PZero/YouTubeController/docs/REQUISITI.md

# Requisiti

## Controller
- Una manopola (encoder rotativo) e un pulsante.
- Collegamento Bluetooth all'iPad.
- Manopola: avanti / indietro nel video, con passo che dipende dalla velocità di rotazione (3 livelli: fine / medio / veloce, secondi regolabili nella PWA; valori iniziali 1 / 5 / 30 s da tarare).
- Pulsante: play / stop.
- Alimentazione: da definire.

## App (PWA su iPad)
- Ricerca di video YouTube.
- Riproduzione del video scelto.
- Interpreta i comandi del controller per avanti/indietro e play/stop.
- Installabile nella schermata Home.

## Scatola
- Stampabile in 3D, contiene tutta l'elettronica.
- Dimensioni, forma e finitura: da definire.

## Da chiarire
- Uso previsto (chi lo usa, in che contesto): influenza ergonomia e interfaccia.
- Autonomia desiderata, se a batteria.
- Funzioni extra (volume, video successivo, pressione lunga): fuori ambito finché non richieste.
