PZero/YouTubeController/docs/foto/anello_led_piazzole.jpg

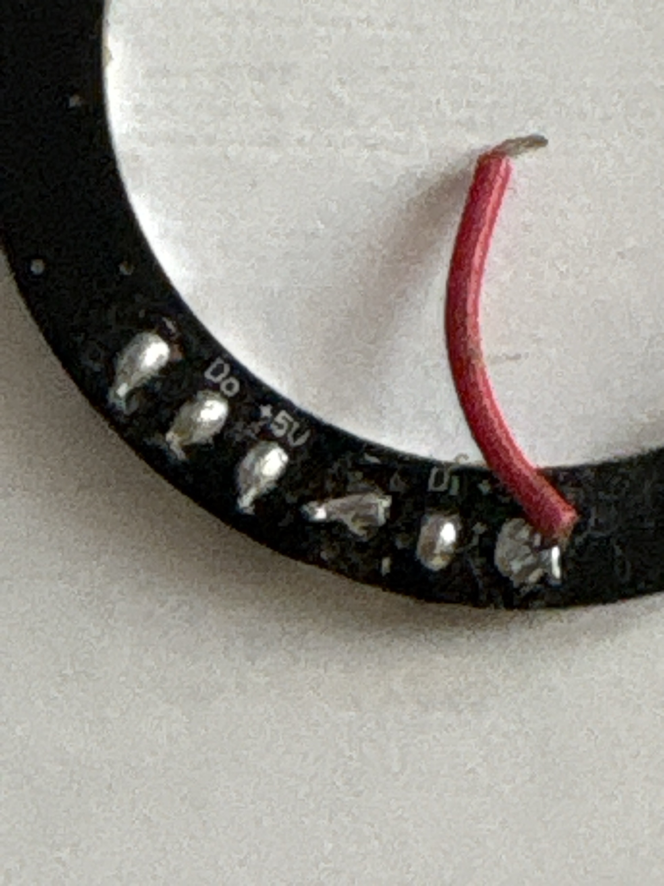
docs/foto/anello_led_piazzole.jpg
