PZero/YouTubeController/docs/foto/led_ws2812_fronte.jpg

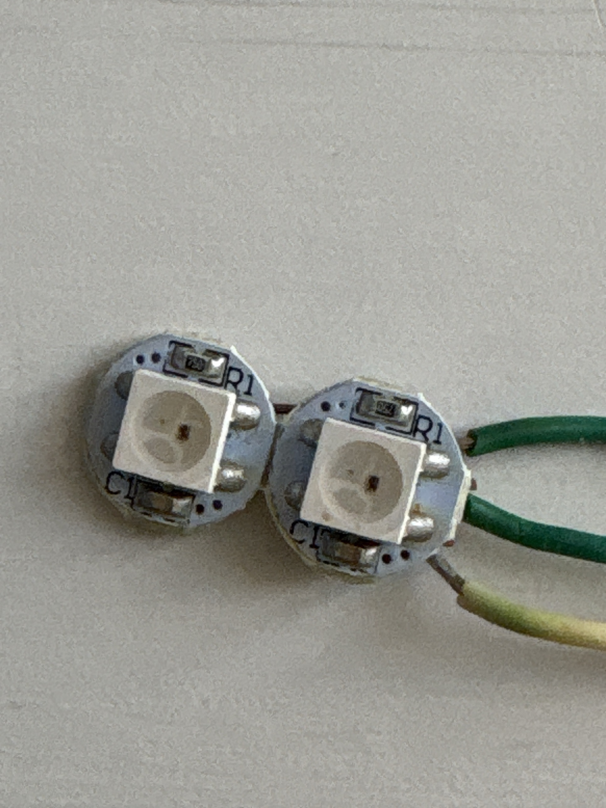
docs/foto/led_ws2812_fronte.jpg
