PZero/YouTubeController/docs/foto/led_ws2812_retro.jpg

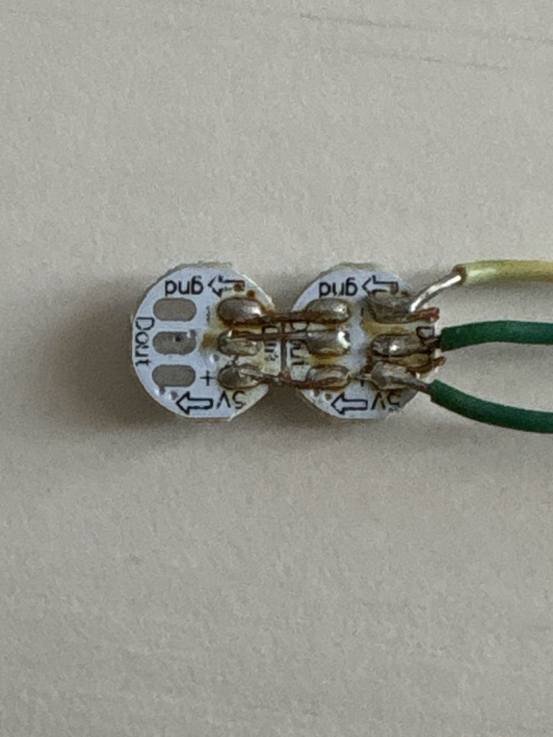
docs/foto/led_ws2812_retro.jpg
