PZero/YouTubeController/pcb/jlcpcb/render/fronte.png

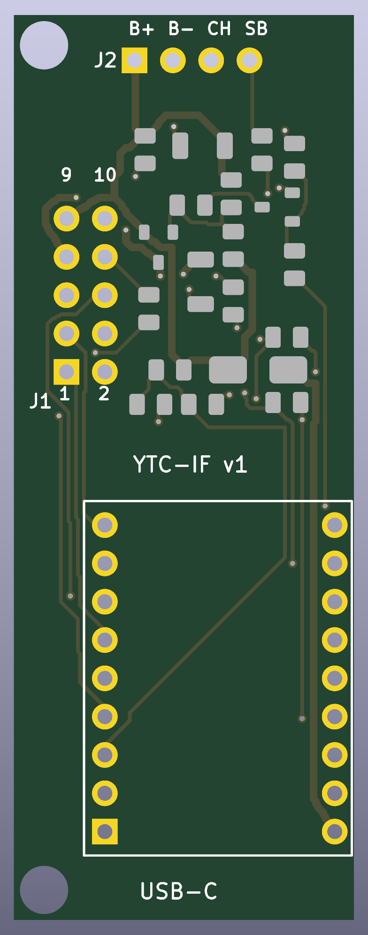
pcb/jlcpcb/render/fronte.png
