PZero/YouTubeController/pcb/jlcpcb/render/retro.png

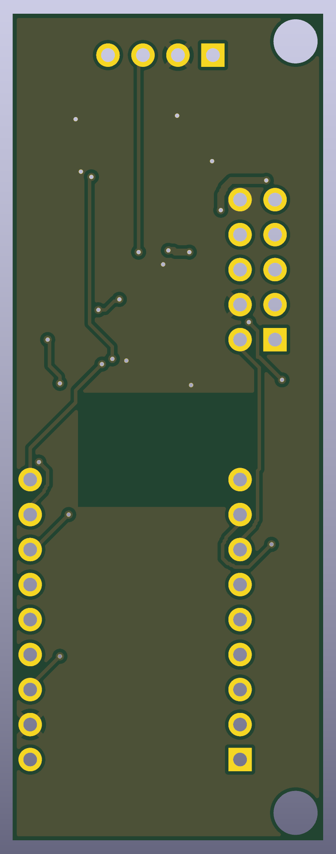
pcb/jlcpcb/render/retro.png
