PZero/YouTubeController/pcb/jlcpcb/BOM.csv

Comment | Designator | Footprint | LCSC Part #
100uF | C1 | C_1206 | C15008
100nF | C2 | C_0805 | C49678
100uF | C3 | C_1206 | C15008
100nF | C4 | C_0805 | C49678
100nF | C5 | C_0805 | C49678
SS14 | D1 | D_SMA | C2480
AO3401A | Q1 | SOT-23 | C15127
MMBT3904 | Q2 | SOT-23 | C20526
4.7k | R1 | R_0805 | C17673
10k | R2,R4,R6,R8 | R_0805 | C17414
2.2k | R3 | R_0805 | C17520
330 | R5 | R_0805 | C17630
100k | R7,R9 | R_0805 | C149504
220k | R10,R11 | R_0805 | C17556
