PZero/YouTubeController/enclosure/verifica_interferenze.scad

// ======================================================================
//  VERIFICA INTERFERENZE (non e' un pezzo da stampare)
//  Per ogni chk = 1..24 esporta l'intersezione tra gruppi di pezzi/componenti:
//    openscad -o chkN.stl -D chk=N verifica_interferenze.scad
//  Esito atteso: "Current top level object is empty" oppure volume 0 (solo facce a contatto:
//  chk 4, 7, 8, 14). Eccezione voluta: chk 11 = piccole nervature di pinzatura del modulo vibrazione
//  (pinch 0,15 mm sui labbri). chk 19 (radici dei ganci nella parete) = solo contatto.
//  Gli inviluppi (encoder_env, led_ring_env, vib_top_env, mf_env, mf_sm_env, cn_env, plug_env) stanno in componenti.scad.
//  2026-10-15 (V1): pacco elettronico LIBERO nella corsia sinistra (pk_env, chk 13 e 24 agli estremi della corsia),
//  connettore volante in tasca (cn_env, chk 21), spina USB-C nella presa del TP4056 dal retro (plug_env, chk 22).
//  Pulsante PBS-110 eliminato il 2026-10-14: chk 2 e 5 (pulsante e cappuccio) ora sono il modulo vibrazione.
// ======================================================================
include <youtube_control.scad>
mode = "none";
chk = 1;
module enc() top_frame() translate([K.x,K.y,0]) encoder_env();
module cell() battery_model();
module elec() { tp4056_model(); }          // TP4056 (il pacco SuperMini + millefori e' mf() = pk_env)
module cn()   cn_env();
module knobw() top_frame() translate([K.x,K.y,knob_gap]) knob();
module knobp() top_frame() translate([K.x,K.y,knob_gap - enc_travel]) knob();   // manopola a fine corsa del pulsante
module collw() if (!led_ring) top_frame() translate([K.x,K.y,0]) collar();
module ring()  top_frame() translate([K.x,K.y,0]) led_ring_env();
module diffw() top_frame() translate([K.x,K.y,0]) diffuser();
module vt()    top_frame() vib_top_env();
module vtp()   top_frame() vib_top_pcb();
module mf()    pk_env();
module newp()  { ring(); vt(); mf(); }
module ringx() top_frame() translate([K.x,K.y,0]) led_ring_model();   // modello (LED reali, non inviluppo)
module ring_feat() top_frame() translate([K.x,K.y,0]) { lr_arms(); lr_stops(); lr_pockets(); }
module encm()  top_frame() translate([K.x,K.y,0]) encoder_model();      // modello (dado, bussola, albero)
if (chk==1)  intersection() { body(); union() { sled(); cell(); elec(); mf(); cn(); } }
if (chk==2)  intersection() { vt();  union() { sled(); cell(); elec(); mf(); cn(); ring(); enc(); } }   // modulo vibrazione vs resto
if (chk==3)  intersection() { enc();  union() { sled(); cell(); elec(); body(); knobw(); collw(); newp(); } }
if (chk==4)  intersection() { union() { cell(); elec(); } sled(); }
if (chk==5)  intersection() { vt(); knobw(); }
if (chk==6)  intersection() { body(); on_walls() panel_local(); }
if (chk==7)  intersection() { sled(); lid(); }
if (chk==8)  intersection() { body(); lid(); }
if (chk==9)  intersection() { union() {knobw(); collw();} body(); }
// nuovi
if (chk==10) intersection() { ringx(); union() { body(); sled(); cell(); elec(); vt(); mf(); knobw(); diffw(); } }
if (chk==11) intersection() { vtp(); body(); }                         // solo PCB vs scocca: nervature di pinzatura (voluto, ~3 mm3)
if (chk==20) intersection() { vt(); body(); }                          // PCB + motore vs scocca: i labbri coprono 1,0 del bordo: nessun componente entro 1,0 dal bordo (~24 mm3 = solo labbri)
if (chk==12) intersection() { vt(); union() { sled(); cell(); elec(); mf(); cn(); lid(); } }
if (chk==13) intersection() { mf(); union() { sled(); cell(); elec(); } }          // millefori (PCB, saldature, componenti) vs portaschede/cella/TP4056/SuperMini: contatto sui sostegni
if (chk==14) intersection() { diffw(); union() { body(); knobw(); } }
if (chk==15) intersection() { on_walls() panel_local(); union() { sled(); cell(); elec(); newp(); cn(); } }
// pulsante dell'encoder: la manopola a fine corsa non deve toccare dado/bussola/anello/diffusore/faccia
module encnut() top_frame() translate([K.x,K.y,0]) {          // dado + rondella (Ø10.4) e bussola oltre la faccia; l'albero scende insieme alla manopola
    cylinder(d=10.4, h=enc_nut_t + enc_washer_t, $fn=48);
    cylinder(d=7, h=enc_bush - wall, $fn=48);
}
if (chk==16) intersection() { knobp(); union() { encnut(); body(); diffw(); ringx(); } }
// sede del modulo vibrazione: ganci/tasche dell'anello e lavorazioni vicine
if (chk==17) intersection() { top_frame() vt_nest(); union() { ring_feat(); ringx(); top_frame() translate([K.x,K.y,0]) diffuser_cut(); } }
// la sede non deve sbucare dalla scocca
if (chk==18) difference() { top_frame() vt_nest(); rbox_t(Rp, Rt, 0); }
// parte della sede dentro le pareti (radici): solo la sovrapposizione di 0,01 con la faccia
if (chk==19) intersection() { top_frame() vt_nest(); difference() { rbox_t(Rp, Rt, 0); rbox_t(Rp-wall, Rt-wall, -0.01); } }

// 2026-10-15: connettore volante in piedi nella tasca (con 5 mm di fili) vs tutto il resto
if (chk==21) intersection() { cn(); union() { body(); on_walls() panel_local(); lid(); cell(); elec(); mf(); ring(); enc(); vt(); knobw(); diffw(); } }
// la tasca (pareti) vs ingombri: bracci dei pannelli, cella, altri sostegni, TP4056
module cn_pocket_only() intersection() { cn_pocket(); translate([0,0,sp_top]) cube([200,200,60], center=false); }
if (chk==23) intersection() { cn_pocket_only(); union() { on_walls() panel_local(); cell(); elec(); mf(); } }
// spina USB-C normale (guscio 12 x 6,5) infilata nella presa del TP4056 dal retro: deve passare dalla finestra 13 x 7 senza toccare nulla
if (chk==22) intersection() { plug_env(); union() { body(); sled(); lid(); cell(); mf(); on_walls() panel_local(); } }
// (chk 24: lanciare con -D pk_dx=.. -D pk_dy=.. agli estremi (+-0,45 / +-0,9): pacco vs scocca, pannelli, sled (nervature), cella, TP4056)
if (chk==24) intersection() { mf(); union() { body(); on_walls() panel_local(); sled(); cell(); tp4056_model(); lid(); } }
