PZero/YouTubeController/pcb/kicad/youtube_controller.kicad_pcb

## KiCad design pcb/kicad/youtube_controller.kicad_pcb (2026-10-15)

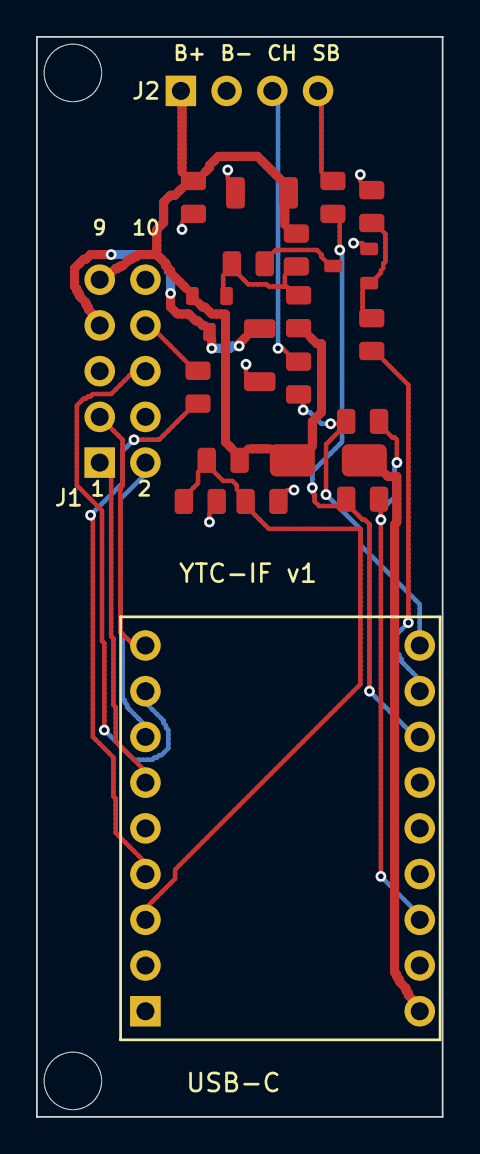
[picture p16: board youtube_controller.kicad_pcb from above]

Board: 2 copper layers, 22.5 x 60.0 mm, 24 parts (0 on the bottom side), 20 nets.

Parts:
C1, C3: 100uF; C_1206
C2, C4, C5: 100nF; C_0805
D1: SS14; D_SMA
H1, H2: M3; M3_HOLE
J1: scocca 2x5 P2.54; HDR_2x5
J2: TP4056 1x4 P2.54; HDR_1x4
Q1: AO3401A; SOT-23
Q2: MMBT3904; SOT-23
R1: 4.7k; R_0805
R2, R4, R6, R8: 10k; R_0805
R3: 2.2k; R_0805
R5: 330; R_0805
R7, R9: 100k; R_0805
R10, R11: 220k; R_0805
SM: ESP32-S3 SuperMini; SM_SUPERMINI

Connections:
3V3: R7.2, R9.2, SM.H3
5V: D1.1, SM.H1
B_Q1: C5.1, Q1.1, R3.2, R4.2
B_Q2: Q2.1, R1.2, R2.1
CHRG: J2.3, R6.1
C_Q2: Q2.3, R3.1
DI: J1.8, R5.2
ENC_A: J1.1, SM.B6
ENC_B: J1.2, SM.B7
GND: C1.2, C2.2, C3.2, C4.2, J1.4, J1.10, J2.2, Q2.2, R2.2, R11.2, SM.H2
GPIO1: C2.1, R10.2, R11.1, SM.B3
GPIO2: R5.1, SM.B4
GPIO8: R6.2, R7.1, SM.H9
GPIO9: R1.1, SM.H8
GPIO10: R8.2, R9.1, SM.H7
LEDP: C1.1, J1.7, Q1.3
STDBY: J2.4, R8.1
SW: J1.3, SM.B9
VBAT: C3.1, C4.1, C5.2, D1.2, J1.9, J2.1, Q1.2, R4.1, R10.1
VIB_IN: J1.6, SM.B8
