PZero/YouTubeController/pcb/layout_pcb.py

# generato da layout_opt.py (seme 6, costo 328.8)
MOV = {
    'Q1': (9.586, 44.605, 180),
    'Q2': (17.460, 47.272, 90),
    'D1': (16.190, 36.477, 180),
    'R1': (18.603, 43.462, 90),
    'R2': (18.603, 50.574, 90),
    'R3': (11.745, 47.399, 180),
    'R4': (14.412, 48.161, 270),
    'R5': (8.951, 40.541, 90),
    'R6': (14.539, 41.049, 270),
    'R7': (18.095, 38.636, 0),
    'R8': (16.444, 51.082, 270),
    'R9': (18.095, 34.318, 0),
    'R10': (10.348, 36.477, 180),
    'R11': (9.078, 34.191, 0),
    'C1': (12.380, 42.319, 270),
    'C2': (12.507, 34.191, 0),
    'C3': (12.507, 51.336, 180),
    'C4': (8.697, 51.082, 270),
    'C5': (14.539, 44.732, 270),
}
