PZero/YouTubeController/pcb/netlist_pcb.py

# -*- coding: utf-8 -*-
"""Netlist e distinta del PCB YouTubeController (derivata da firmware/millefori/millefori.py, verificata li').
Variazioni rispetto alla millefori: Q1 = P-MOSFET AO3401A (G,S,D = pin 1,2,3), R3 2,2k, C5 100 nF gate-source.
Pin: SM = fori SuperMini 'B1'..'B9' (colonna sinistra TX,RX,1..7) e 'H1'..'H9' (colonna destra 5V,GND,3V3,13..8)."""

# ref: (footprint, valore, LCSC, descrizione BOM)
PARTI = {
    "Q1": ("SOT-23", "AO3401A", "C15127", "P-MOSFET 30V 4A AO3401A"),
    "Q2": ("SOT-23", "MMBT3904", "C20526", "NPN MMBT3904"),
    "D1": ("D_SMA", "SS14", "C2480", "Schottky 1A 40V SS14"),
    "R1": ("R_0805", "4.7k", "C17673", "4,7k 1% 0805"),
    "R2": ("R_0805", "10k", "C17414", "10k 1% 0805"),
    "R3": ("R_0805", "2.2k", "C17520", "2,2k 1% 0805"),
    "R4": ("R_0805", "10k", "C17414", "10k 1% 0805"),
    "R5": ("R_0805", "330", "C17630", "330 1% 0805"),
    "R6": ("R_0805", "10k", "C17414", "10k 1% 0805"),
    "R7": ("R_0805", "100k", "C149504", "100k 1% 0805"),
    "R8": ("R_0805", "10k", "C17414", "10k 1% 0805"),
    "R9": ("R_0805", "100k", "C149504", "100k 1% 0805"),
    "R10": ("R_0805", "220k", "C17556", "220k 1% 0805"),
    "R11": ("R_0805", "220k", "C17556", "220k 1% 0805"),
    "C1": ("C_1206", "100uF", "C15008", "100uF 6,3V X5R 1206 (bulk anello)"),
    "C2": ("C_0805", "100nF", "C49678", "100nF 50V X7R 0805 (filtro ADC)"),
    "C3": ("C_1206", "100uF", "C15008", "100uF 6,3V X5R 1206 (bulk motore)"),
    "C4": ("C_0805", "100nF", "C49678", "100nF 50V X7R 0805 (motore)"),
    "C5": ("C_0805", "100nF", "C49678", "100nF 50V X7R 0805 (soft start gate Q1)"),
}

# net: [(ref, pad)]
NETS = {
    "GND": [("SM", "H2"), ("J2", 2), ("J1", 4), ("J1", 10), ("Q2", 2), ("R2", 2), ("R11", 2), ("C1", 2), ("C2", 2), ("C3", 2), ("C4", 2)],
    "VBAT": [("J2", 1), ("D1", 2), ("Q1", 2), ("R4", 1), ("R10", 1), ("C3", 1), ("C4", 1), ("C5", 2), ("J1", 9)],
    "5V": [("SM", "H1"), ("D1", 1)],
    "3V3": [("SM", "H3"), ("R7", 2), ("R9", 2)],
    "LEDP": [("Q1", 3), ("C1", 1), ("J1", 7)],
    "DI": [("R5", 2), ("J1", 8)],
    "GPIO2": [("SM", "B4"), ("R5", 1)],
    "B_Q1": [("Q1", 1), ("R4", 2), ("R3", 2), ("C5", 1)],
    "C_Q2": [("Q2", 3), ("R3", 1)],
    "B_Q2": [("Q2", 1), ("R1", 2), ("R2", 1)],
    "GPIO9": [("SM", "H8"), ("R1", 1)],
    "GPIO1": [("SM", "B3"), ("R10", 2), ("R11", 1), ("C2", 1)],
    "GPIO8": [("SM", "H9"), ("R6", 2), ("R7", 1)],
    "CHRG": [("J2", 3), ("R6", 1)],
    "GPIO10": [("SM", "H7"), ("R8", 2), ("R9", 1)],
    "STDBY": [("J2", 4), ("R8", 1)],
    "ENC_A": [("SM", "B6"), ("J1", 1)],
    "ENC_B": [("SM", "B7"), ("J1", 2)],
    "VIB_IN": [("SM", "B8"), ("J1", 6)],
    "SW": [("SM", "B9"), ("J1", 3)],
}
POWER_NETS = ["VBAT", "LEDP", "5V"]
