PZero/YouTubeController/(commit log)

2026-10-09 Avvio progetto: struttura, subagenti, documenti e script OpenSCAD della scatola
    [youtube_control.scad]
2026-10-09 Scheda ESP32-S3 SuperMini: specifiche, pinout, misure e decisione
2026-10-09 Quote meccaniche ESP32-S3 SuperMini da disegno Nologo; corretti BOM e README
2026-10-09 Decisione: viti autofilettanti per il portaschede
2026-10-09 Componenti: quote e datasheet di TP4056, encoder EC11E, pulsante PBS-110, MT3608; rischio retroalimentazione
2026-10-09 Scatola: pulsante PBS-110, manopola zigrinata 18T, portaschede modulare con culla 18650, 3 piatti di stampa, render
    [componenti.scad, portaschede.scad, youtube_control.scad]
2026-10-09 Scritte disattivate; decisioni presa USB-C e scritte
    [youtube_control.scad]
2026-10-09 Fine sessione: stato, decisioni GitHub/Pages, minuteria in BOM
2026-10-09 App: pagina di prova tastiera/focus per iPad e pubblicazione GitHub Pages di app/
2026-10-09 Decisione: niente ricarica wireless
2026-10-09 Fine sessione: pagina di prova online su GitHub Pages, stato aggiornato
2026-10-11 PWA: ricerca, preferiti con loop A-B, seek a 3 velocità, schermo pieno, icona
2026-10-11 README del repository con foto e render; anello LED, vibrazione e millefori: elettronica e scatola
2026-10-11 Fine sessione: millefori 8x13 con verifica, ESP32 e batteria misurati, TP4056 confermato, stato aggiornato
2026-10-14 Test dei comandi su breadboard: encoder, pulsante, anello, vibrazione e monitor web
2026-10-14 Pulsante integrato nell'encoder (PBS-110 eliminato), vibrazione sulla scocca, stampa per colori; firmware v0 con tastiera BLE, portale WiFi e OTA
2026-10-15 Firmware 0.1.2: tastiera BLE funzionante con iPad, vibrazione, OTA senza crash; decisioni diodo e millefori 8x20
2026-10-15 PWA 1.1.4: il focus resta ai comandi in schermo pieno
2026-10-15 Millefori 8x20 con SuperMini saldata, diodo 1N5817 e codino 2x5 (verifica OK); archiviata la 8x13
2026-10-15 Scatola: millefori 8x20 piatta con SuperMini saldata, finestra USB-C sul fronte, tasca connettore 2x5
2026-10-15 PCB JLCPCB della scheda di interfaccia: progetto KiCad, Gerber, BOM, CPL (DRC 0 errori)
2026-10-15 PCB: correzione rotazione SOT-23 nel CPL per JLCPCB
2026-10-15 PCB: rotazione SOT-23 verificata sull'anteprima JLCPCB
2026-10-15 Scatola V1: millefori libera nella corsia, fronte senza finestra USB
2026-10-15 Decisione: interruttore interno al posto del diodo per la V1
2026-10-15 Fine sessione: firmware 0.1.3 con BLE funzionante e autospegnimento, PWA 1.1.4, scatola V1, PCB JLCPCB pronto; stato e decisioni aggiornati
